KravitzLabDevices/Head_fixed_wheel/Parts_list/README.md

# Headfixed_5sipper
This is a repository containing parts and code for a 5-spout sipper device for head-fixed mouse experiments
