KravitzLabDevices/Head_fixed_wheel/Arduino_Code/Dependency_libraries/README

#GitHub Repositories for Arduino Libraries
## Download all .zip files and use Sketch >> 'add library' in Arduino IDE

## HG 12.4.2024
