KravitzLabDevices/Head_fixed_wheel/Parts_list/HeadfixedSipper_parts.xlsx

Sheet: All
REF | Part Name | Amount per wheel | Source (linked) | Part no. | Notes
To Purchase, Frame
F1 | 8" long, 1x1" 80/20 extruded aluminum rail | 8 per setup | 1010-Black | 1.00” X 1.00” T-Slotted Profile - Four Open T-Slots (https://8020.net/1010-black.html) | 1010-Black | Can be purchased through Workday from supplier "80-20 Inc"
F2 | Railing-to-headfix bracket 1 | 2 | THOR (https://www.thorlabs.com/thorproduct.cfm?partnumber=UPH1) | UPH1 (https://www.thorlabs.com/thorproduct.cfm?partnumber=UPH1)
F3 | Head-fix bars | 2 | OFMD | Ask Kevin! Send pictures :D
F4 | Optical table base | 1 x (300mm x 300mm minimum) + 1 x (125 x 125mm) (use P8 if necessary) | THOR (https://www.thorlabs.com/thorproduct.cfm?partnumber=MB3045/M) | MB3045/M (https://www.thorlabs.com/thorproduct.cfm?partnumber=MB3045/M)
F5 | Railing-to-headfix bracket 2 | 2 | THOR (https://www.thorlabs.com/thorproduct.cfm?partnumber=RA90TR) | RA90TR (https://www.thorlabs.com/thorproduct.cfm?partnumber=RA90TR)
F6 | Bracket, F1 to F4/P8 | 2 minimum, 4 recommended | Amazon, best I can find (https://www.amazon.com/Aluminum-Extrusion-Profile-Carbon-Bracket/dp/B0C7FQCY2J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) | or print it (P7)
F7 | Post, F2 to F5 | 2 | THOR (https://www.thorlabs.com/thorproduct.cfm?partnumber=TRA75/M) | TRA75/M (https://www.thorlabs.com/thorproduct.cfm?partnumber=TRA75/M)
F8 | 10 cm Threaded rod, elevates a P8 platform above base | 4 | THOR (https://www.thorlabs.com/thorproduct.cfm?partnumber=TRA100/M) | TRA100/M (https://www.thorlabs.com/thorproduct.cfm?partnumber=TRA75/M)
To Purchase, Wheel
R1 | Ball Bearings | 2 | Amazon (https://www.amazon.com/608-2RS-Skateboard-Bearing-Rolling-bearings/dp/B073ST742Z?hvadid=79920803460020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) | 608-2RS
R2 | Axle | 1 | Amazon (https://www.amazon.com/TOP-VIGOR-Threaded-Stainless-Threads-Studding/dp/B0D2624D6M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) | TOP VIGOR
R3 | Axle Coupling | 1 | Amazon (https://www.amazon.com/ZYCST-Aluminium-Coupling-Connector-Airplane/dp/B07QPJLQNH) | Treehobby, 6mm:6mm
R4 | Rotary encoder | 1 | Adafruit I2C Stemma QT (https://www.adafruit.com/product/5880) | Product ID: 5880
To Purchase, Liquid Dispensing
L1 | Modular, Linear Translation Stage | 3 modular parts for 3-axis manipulation, elevated by platform P8 (see frame) | Ebay, or PDV (https://www.ebay.com/itm/133963500697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) | 133963500697, or 2x "PP140-50" + 1x "PT-LWX90"
L2 | Solenoid valve | 1 minimum, up to 5 | The Lee Co (https://www.theleeco.com/product/hypodermic-port-outlet-vhs-series-solenoid-valve/) | INKA2426212H
L3 | Tubing | 2x ~3"-long tubing per solenoid valve-spout set (up to 10x) | Amazon (https://www.amazon.com/VictorsHome-Silicone-Flexible-Transfer-Transparent/dp/B09DKWWV7N) | VictorsHome
L4 | Metal Spouts (hand-bent) | 1 minimum, up to 5 | Amazon (https://www.amazon.com/uxcell-Stainless-Capillary-Industry-Machinery/dp/B0BX4BYH85) | uxcel
L5 | Liquid dispenser, 10mL Syringe | 1 minimum, up to 5 | Amazon (https://www.amazon.com/10ml-Syringe-Sterile-BH-SUPPLIES/dp/B07KW4KLG2) | BH Supplies
L6 | Rotary and extension servos | 2 | Amazon, best I can find (https://www.amazon.com/BETU-Servos-Helicopter-Airplane-Models/dp/B0BF8WZ7FK?xpid=A95qRS8cjkFae) | BETY
L7 | Solid-state relay (Dig. >> Ana.), sippers | 1 minimum, up to 5 | DigiKey (https://www.digikey.com/en/products/detail/littelfuse-inc/LCA715/1973278) | 5656-LCA715-ND
L8 | 2-pin Male JST cable | 1 minimum, up to 5 | Amazon (https://www.amazon.com/Upgraded-Connector-Battery-Inductrix-Eachine/dp/B07NWD5NTN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) | elechawk
L9 | Copper tape | Small amount, cut into ~2.5mm wide strip | Amazon, best I can find (https://www.amazon.com/Conductive-Adhesive-Soldering-Shielding-Grounding/dp/B09C24PNSW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) | Chanzon
L10 | One-channel relay, trigger for solenoids | 1 minimum, up to 5 | Amazon (https://www.amazon.com/HiLetgo-Channel-Optocoupler-Isolation-Trigger/dp/B0CHFJSNP6?xpid=0ctCJmBtzedeI) | HiLetGo
To print, wheel
P1 | Left wheel stand | 1 | GitHub/3D Designs | "Left_stand.stl"
P2 | Right wheel stand | 1 | GitHub/3D Designs | "Right_stand.stl"
P3 | Wheel | 1 | GitHub/3D Designs | "Wheel.stl"
OPTIONAL PRINT, INSTEAD OF ATTACHED LEFT ARM WITH ENCODER:
P1.1 | Left wheel stand | 1 | GitHub/3D Designs | "Magnificent Borwo.stl"
P1.2 | Rotary encoder stand (left) | 1 | GitHub/3D Designs | "Magnificent Borwo.stl"
To print, liquid dispensing
P4 | Spout setting | 1 | GitHub/3D Designs | Spout_holder.stl
P5 | Servo coupler/Extender arm | 1 | GitHub/3D Designs | Extender_arm.stl
P6 | Liquid Header | 1 | GitHub/3D Designs | Liquid_assembly.stl
OPTIONAL PRINTING FOR FRAME (F4 and F6 REPLACED BY P7 and P8)
P7 (r. F6) | Bracket, F1 to F4/P8 (printed) | 2 minimum, 4 recommended | GitHub/3D Designs | "Optical_board_bracket.stl"
P8 (r. F4) | Optical table base (printed, snap-together) | Each 125x125mm, 10 recommended (3x3 + 1) | GitHub/3D Designs | "Breadboard_125mm_interlocking.stl"
P8.1 | P8 snap-together L-brackets | 16 for 3x3 P8 assembly | GitHub/3D Designs | "Breadboard_125mm_long_peg.stl"
HARDWARE
H1 | 4040 Frame railing hardware | 4 x corner brackets, up to 12x T connectors + M8 bolts | Amazon.com: 24pcs Seekliny 4040 Aluminum Extrusion Corner Bracket 4040 Hardware V-Slot Accessories T-Slot with Screws for 8020 Aluminum Profile 3D Printer Accessories Black : Industrial & Scientific (https://www.amazon.com/Seekliny-Aluminum-Extrusion-Hardware-Accessories/dp/B0CWV1XTFY?th=1)
H2 | M6 hardware, assorte | 8x for frame to optical table, 4x for platform | Amazon.com: 172 Pcs M6 Screws Assortment Kit, M6x 8/10/12/16/20/25/30/35mm M6 Bolts Kit, 304 Stainless Steel Hex Socket Head Screws Nuts Bolts and Washers Set : Industrial & Scientific (https://www.amazon.com/Screws-Assortment-Stainless-Socket-Washers/dp/B0DFWMGFDM?s=hi)
H3 | M4 short binding barrel | 4x to attach 1 x P8 as platform to F7 | Amazon.com: Bettomshin 25Pcs M4 Binding Screw, M4 x 6mm Nickel Plated Carbon Steel Cross Head Butt Screw Binding Post Screw Kit for Scrapbook Photo Albums Bookbinding DIY Leather Saddles Purses Belt : Industrial & Scientific (https://www.amazon.com/Bettomshin-Binding-Scrapbook-Leather-Saddles/dp/B09SL155B8?s=hi)
H4 | 4040 Inside corner brackets (optional, if not using H1) | 4 x corner brackets + set screws | Amazon.com: 24pcs Seekliny 4040 Aluminum Extrusion Corner Bracket 4040 Hardware V-Slot Accessories T-Slot with Screws for 8020 Aluminum Profile 3D Printer Accessories Black : Industrial & Scientific (https://www.amazon.com/Seekliny-Aluminum-Extrusion-Hardware-Accessories/dp/B0CWV414WY?th=1)
H5 | Optical board pad/leveler | 4x | uxcell M6 x 25 x 30mm Hand Screw Leveling Feet Adjustable Leveler Floor Protector for Machine Furniture Table Desk Leg 4 Pack - Amazon.com (https://www.amazon.com/uxcell-Leveling-Adjustable-Protector-Furniture/dp/B07HG2B3W5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)
H6 | M2 socket cap bolts | 2x for headbar to mouse headfix cap | Amazon.com: Kozelo 10pcs Socket Head Cap Screws - [M2-0.4 x 8mm] Alloy Steel Black Oxide Grade 12.9 Internal Hex Screw for 3D Printer Furniture Industrial Use, Black : Industrial & Scientific (https://www.amazon.com/Kozelo-10pcs-Socket-Head-Screws/dp/B0DDKGT7H2?s=hi&sp_csd=d2lkZ2V0TmFtZT1zcF9hdGY)
H7 | Set Screws come with all THORLABS equipment, but are all M4. Can be found here: |  | https://www.amazon.com/Kadrick-Stainless-Screws-3mm-16mm-Lengths/dp/B0D962TJHX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
H8 | 1cm spacer | 2x [OPTIONAL, FOR SEPARATED ENCODER], holds rotary encoder stand at same level as axle | 10 Pack Round Rubber Spacers 1" OD x 3/8" ID x 1" Inch Thickness Black Thick Rubber Washers 1 Inch Round Rubber Spacer Rubber Bushings Flat Washers: Amazon.com: Industrial & Scientific (https://www.amazon.com/Rubber-Spacers-Thickness-Washers-Bushings/dp/B0CJ8XMS5C)
H9 | Sealant tape | Some length to cover axle and create tighter interface between axle and wheel | Dixon Valve TTB75 PTFE Industrial Sealant Tape, -212 to 500 Degree F Temperature Range, 3.5mil Thick, 520" Length, 3/4" Width, White: Thread Sealants: Amazon.com: Industrial & Scientific (https://www.amazon.com/Dixon-Valve-TTB75-Industrial-Temperature/dp/B003D7K8E0)
H10 | Nylon M2 hardware | 4x to secure rotary encoder to encoder stand | Lystaii 320pcs M2 Nylon Hex Spacer Standoff Kit Male Female Screw Nut Threaded Pillar Hex Standoff PCB Motherboard Circuit Board Standoffs Mounting Hardware Spacer Assortment Kit (Black, M2): Amazon.com: Industrial & Scientific (https://www.amazon.com/Lystaii-Standoff-Motherboard-Standoffs-Assortment/dp/B0BYSHZ2TD)
H11 | Miniature zipties | Up to 5, secure capacitive lick wiring to spout | Amazon.com: Nirah Industrial Grade Small Zip Ties 4 inches, Black, 1000 Pack, UV Resistant Multi-Purpose, Tiny Cable Ties, Mini Tie Wraps : Electronics (https://www.amazon.com/Nirah-Industrial-Resistant-Multi-Purpose-Premium/dp/B0BRWSZ57B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)
H12 | Servo Screws | Secure servos to rotary and linear extenders | HanTof 700Pcs Tiny Phillips Pan Head with Washer Self Tapping Screws, 304 Stainless Steel, Small/Mini M2 M2.3 M2.6 M3 Wood Screws, Micro Sheet Metal Screws Assortment Kit for Eletronic and Toy Repair: Amazon.com: Industrial & Scientific (https://www.amazon.com/HanTof-Phillips-Assortment-Eletronic-Stainless/dp/B0C4T1ZDYL)

Sheet: Frame Assembly
REF | Part Name | Amount per wheel | Source (linked) | Part no.
F1 | Frame railing/Extruded Rods | 3 minimum (one set of framework), 6 recommended | Alexnld (https://alexnld.com/product/machifit-400mm-length-4040-t-slot-aluminum-profiles-extrusion-frame-for-cnc/) | Product ID:5451518 (https://alexnld.com/product/machifit-400mm-length-4040-t-slot-aluminum-profiles-extrusion-frame-for-cnc/)
F2 | Railing-to-headfix bracket 1 | 2 | THOR (https://www.thorlabs.com/thorproduct.cfm?partnumber=UPH1) | UPH1 (https://www.thorlabs.com/thorproduct.cfm?partnumber=UPH1)
F3 | Head-fix bars | 2 | OFMD | Ask Kevin! Send pictures :D
F4 | Optical table base | 1 x (300mm x 300mm minimum) + 1 x (125 x 125mm) (use P8 if necessary) | THOR (https://www.thorlabs.com/thorproduct.cfm?partnumber=MB3045/M) | MB3045/M (https://www.thorlabs.com/thorproduct.cfm?partnumber=MB3045/M)
F5 | Railing-to-headfix bracket 2 | 2 | THOR (https://www.thorlabs.com/thorproduct.cfm?partnumber=RA90TR) | RA90TR (https://www.thorlabs.com/thorproduct.cfm?partnumber=RA90TR)
F6 | Bracket, F1 to F4/P8 | 2 minimum, 4 recommended | Amazon, best I can find (https://www.amazon.com/Aluminum-Extrusion-Profile-Carbon-Bracket/dp/B0C7FQCY2J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) | or print it (P7)
F7 | Post, F2 to F5 | 2 | THOR (https://www.thorlabs.com/thorproduct.cfm?partnumber=TRA75/M) | TRA75/M (https://www.thorlabs.com/thorproduct.cfm?partnumber=TRA75/M)
F8 | 10 cm Threaded rod, elevates a P8 platform above base | 4 | THOR (https://www.thorlabs.com/thorproduct.cfm?partnumber=TRA100/M) | TRA100/M (https://www.thorlabs.com/thorproduct.cfm?partnumber=TRA75/M)
OPTIONAL: PRINTING F4 and F6 INSTEAD OF PURCHASE
P7 (r. F6) | Bracket, F1 to F4/P8 (printed) | 2 minimum, 4 recommended | GitHub/3D Designs | "Optical_board_bracket.stl"
P8 (r. F4) | Optical table base (printed, snap-together) | Each 125x125mm, 10 recommended (3x3 + 1) | GitHub/3D Designs | "Breadboard_125mm_interlocking.stl"
P8.1 | P8 snap-together L-brackets | 16 for 3x3 P8 assembly | GitHub/3D Designs | "Breadboard_125mm_long_peg.stl"
HARDWARE
H1 | 4040 Frame railing hardware | 4 x corner brackets, up to 12x T connectors + M8 bolts | Amazon.com: 24pcs Seekliny 4040 Aluminum Extrusion Corner Bracket 4040 Hardware V-Slot Accessories T-Slot with Screws for 8020 Aluminum Profile 3D Printer Accessories Black : Industrial & Scientific (https://www.amazon.com/Seekliny-Aluminum-Extrusion-Hardware-Accessories/dp/B0CWV1XTFY?th=1)
H2 | M6 hardware, assorte | 8x for frame to optical table, 4x for platform | Amazon.com: 172 Pcs M6 Screws Assortment Kit, M6x 8/10/12/16/20/25/30/35mm M6 Bolts Kit, 304 Stainless Steel Hex Socket Head Screws Nuts Bolts and Washers Set : Industrial & Scientific (https://www.amazon.com/Screws-Assortment-Stainless-Socket-Washers/dp/B0DFWMGFDM?s=hi)
H3 | M4 short binding barrel | 4x to attach 1 x P8 as platform to F7 | Amazon.com: Bettomshin 25Pcs M4 Binding Screw, M4 x 6mm Nickel Plated Carbon Steel Cross Head Butt Screw Binding Post Screw Kit for Scrapbook Photo Albums Bookbinding DIY Leather Saddles Purses Belt : Industrial & Scientific (https://www.amazon.com/Bettomshin-Binding-Scrapbook-Leather-Saddles/dp/B09SL155B8?s=hi)
H4 | 4040 Inside corner brackets (optional, if not using H1) | 4 x corner brackets + set screws | Amazon.com: 24pcs Seekliny 4040 Aluminum Extrusion Corner Bracket 4040 Hardware V-Slot Accessories T-Slot with Screws for 8020 Aluminum Profile 3D Printer Accessories Black : Industrial & Scientific (https://www.amazon.com/Seekliny-Aluminum-Extrusion-Hardware-Accessories/dp/B0CWV414WY?th=1)
H5 | Optical board pad/leveler | 4x | uxcell M6 x 25 x 30mm Hand Screw Leveling Feet Adjustable Leveler Floor Protector for Machine Furniture Table Desk Leg 4 Pack - Amazon.com (https://www.amazon.com/uxcell-Leveling-Adjustable-Protector-Furniture/dp/B07HG2B3W5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)
H6 | M2 socket cap bolts | 2x for headbar to mouse headfix cap | Amazon.com: Kozelo 10pcs Socket Head Cap Screws - [M2-0.4 x 8mm] Alloy Steel Black Oxide Grade 12.9 Internal Hex Screw for 3D Printer Furniture Industrial Use, Black : Industrial & Scientific (https://www.amazon.com/Kozelo-10pcs-Socket-Head-Screws/dp/B0DDKGT7H2?s=hi&sp_csd=d2lkZ2V0TmFtZT1zcF9hdGY)
H7 | Set Screws come with all THORLABS equipment, but are all M4. Can be found here: |  | https://www.amazon.com/Kadrick-Stainless-Screws-3mm-16mm-Lengths/dp/B0D962TJHX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

Sheet: Wheel Assembly
REF | Part Name | Amount per wheel | Source | Part no.
R1 | Ball Bearings | 2 | Amazon (https://www.amazon.com/608-2RS-Skateboard-Bearing-Rolling-bearings/dp/B073ST742Z?hvadid=79920803460020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) | 608-2RS
R2 | Axle | 1 | Amazon (https://www.amazon.com/TOP-VIGOR-Threaded-Stainless-Threads-Studding/dp/B0D2624D6M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) | TOP VIGOR
R3 | Axle Coupling | 1 | Amazon (https://www.amazon.com/ZYCST-Aluminium-Coupling-Connector-Airplane/dp/B07QPJLQNH) | Treehobby, 6mm:6mm
R4 | Rotary encoder | 1 | Adafruit I2C Stemma QT (https://www.adafruit.com/product/5880) | Product ID: 5880
P1 | Left wheel stand | 1 | GitHub/3D Designs | "Left_stand.stl"
P2 | Right wheel stand | 1 | GitHub/3D Designs | "Right_stand.stl"
P3 | Wheel | 1 | GitHub/3D Designs | "Wheel.stl"
OPTIONAL PRINT, INSTEAD OF SINGLE LEFT ARM WITH ENCODER:
P1.1 | Left wheel stand | 1 | GitHub/3D Designs | "Magnificent Borwo.stl"
P1.2 | Rotary encoder stand (left) | 1 | GitHub/3D Designs | "Magnificent Borwo.stl"
HARDWARE
H2 | M6 hardware, assorted | Lock nuts, spacers, and nuts to secure rod, and 4x M6 nuts to secure stands to optical table | Amazon.com: 172 Pcs M6 Screws Assortment Kit, M6x 8/10/12/16/20/25/30/35mm M6 Bolts Kit, 304 Stainless Steel Hex Socket Head Screws Nuts Bolts and Washers Set : Industrial & Scientific (https://www.amazon.com/Screws-Assortment-Stainless-Socket-Washers/dp/B0DFWMGFDM?s=hi)
H7 | M4 Set screws | 2x for axle coupling | https://www.amazon.com/Kadrick-Stainless-Screws-3mm-16mm-Lengths/dp/B0D962TJHX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
H8 | 1cm spacer | 2x [OPTIONAL, FOR SEPARATED ENCODER], holds rotary encoder stand at same level as axle | 10 Pack Round Rubber Spacers 1" OD x 3/8" ID x 1" Inch Thickness Black Thick Rubber Washers 1 Inch Round Rubber Spacer Rubber Bushings Flat Washers: Amazon.com: Industrial & Scientific (https://www.amazon.com/Rubber-Spacers-Thickness-Washers-Bushings/dp/B0CJ8XMS5C)
H9 | Sealant tape | Some length to cover axle and create tighter interface between axle and wheel | Dixon Valve TTB75 PTFE Industrial Sealant Tape, -212 to 500 Degree F Temperature Range, 3.5mil Thick, 520" Length, 3/4" Width, White: Thread Sealants: Amazon.com: Industrial & Scientific (https://www.amazon.com/Dixon-Valve-TTB75-Industrial-Temperature/dp/B003D7K8E0)
H10 | Nylon M2 hardware | 4x to secure rotary encoder to encoder stand | Lystaii 320pcs M2 Nylon Hex Spacer Standoff Kit Male Female Screw Nut Threaded Pillar Hex Standoff PCB Motherboard Circuit Board Standoffs Mounting Hardware Spacer Assortment Kit (Black, M2): Amazon.com: Industrial & Scientific (https://www.amazon.com/Lystaii-Standoff-Motherboard-Standoffs-Assortment/dp/B0BYSHZ2TD)

Sheet: Liquid Assembly
REF | Part Name | Amount per wheel | Source | Part no.
L1 | Modular, Linear Translation Stage | 3 modular parts for 3-axis manipulation, elevated by platform P8 (see frame) | Ebay, or PDV (https://www.ebay.com/itm/133963500697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) | 133963500697, or 2x "PP140-50" + 1x "PT-LWX90"
L2 | Solenoid valve | 1 minimum, up to 5 | The Lee Co (https://www.theleeco.com/product/hypodermic-port-outlet-vhs-series-solenoid-valve/) | INKA2426212H
L3 | Tubing | 2x ~3"-long tubing per solenoid valve-spout set (up to 10x) | Amazon (https://www.amazon.com/VictorsHome-Silicone-Flexible-Transfer-Transparent/dp/B09DKWWV7N) | VictorsHome
L4 | Metal Spouts (hand-bent) | 1 minimum, up to 5 | Amazon (https://www.amazon.com/uxcell-Stainless-Capillary-Industry-Machinery/dp/B0BX4BYH85) | uxcel
L5 | Liquid dispenser, 10mL Syringe | 1 minimum, up to 5 | Amazon (https://www.amazon.com/10ml-Syringe-Sterile-BH-SUPPLIES/dp/B07KW4KLG2) | BH Supplies
L6 | Rotary and extension servos | 2 | Amazon, best I can find (https://www.amazon.com/BETU-Servos-Helicopter-Airplane-Models/dp/B0BF8WZ7FK?xpid=A95qRS8cjkFae) | BETY
L7 | Solid-state relay (Dig. >> Ana.), sippers | 1 minimum, up to 5 | DigiKey (https://www.digikey.com/en/products/detail/littelfuse-inc/LCA715/1973278) | 5656-LCA715-ND
L8 | 2-pin Male JST cable | 1 minimum, up to 5 | Amazon (https://www.amazon.com/Upgraded-Connector-Battery-Inductrix-Eachine/dp/B07NWD5NTN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) | elechawk
L9 | Copper tape | Small amount, cut into ~2.5mm wide strip | Amazon, best I can find (https://www.amazon.com/Conductive-Adhesive-Soldering-Shielding-Grounding/dp/B09C24PNSW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) | Chanzon
L10 | One-channel relay, trigger for solenoids | 1 minimum, up to 5 | Amazon (https://www.amazon.com/HiLetgo-Channel-Optocoupler-Isolation-Trigger/dp/B0CHFJSNP6?xpid=0ctCJmBtzedeI) | HiLetGo
P4 | Spout setting | 1 | GitHub/3D Designs | Spout_holder.stl
P5 | Servo coupler/Extender arm | 1 | GitHub/3D Designs | Extender_arm.stl
P6 | Liquid Header | 1 | GitHub/3D Designs | Liquid_assembly.stl
HARDWARE
H10 | Nylon M2 hardware | 4x to secure servos in slots | Lystaii 320pcs M2 Nylon Hex Spacer Standoff Kit Male Female Screw Nut Threaded Pillar Hex Standoff PCB Motherboard Circuit Board Standoffs Mounting Hardware Spacer Assortment Kit (Black, M2): Amazon.com: Industrial & Scientific (https://www.amazon.com/Lystaii-Standoff-Motherboard-Standoffs-Assortment/dp/B0BYSHZ2TD)
H11 | Miniature zipties | Up to 5, secure capacitive lick wiring to spout | Amazon.com: Nirah Industrial Grade Small Zip Ties 4 inches, Black, 1000 Pack, UV Resistant Multi-Purpose, Tiny Cable Ties, Mini Tie Wraps : Electronics (https://www.amazon.com/Nirah-Industrial-Resistant-Multi-Purpose-Premium/dp/B0BRWSZ57B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)
H12 | Servo Screws | Secure servos to rotary and linear extenders | HanTof 700Pcs Tiny Phillips Pan Head with Washer Self Tapping Screws, 304 Stainless Steel, Small/Mini M2 M2.3 M2.6 M3 Wood Screws, Micro Sheet Metal Screws Assortment Kit for Eletronic and Toy Repair: Amazon.com: Industrial & Scientific (https://www.amazon.com/HanTof-Phillips-Assortment-Eletronic-Stainless/dp/B0C4T1ZDYL)
