KravitzLabDevices/Head_fixed_wheel/PCB_Designs/JustinWheelPCB1.2.brd

## EAGLE design PCB_Designs/JustinWheelPCB1.2.brd (2025-12-03)

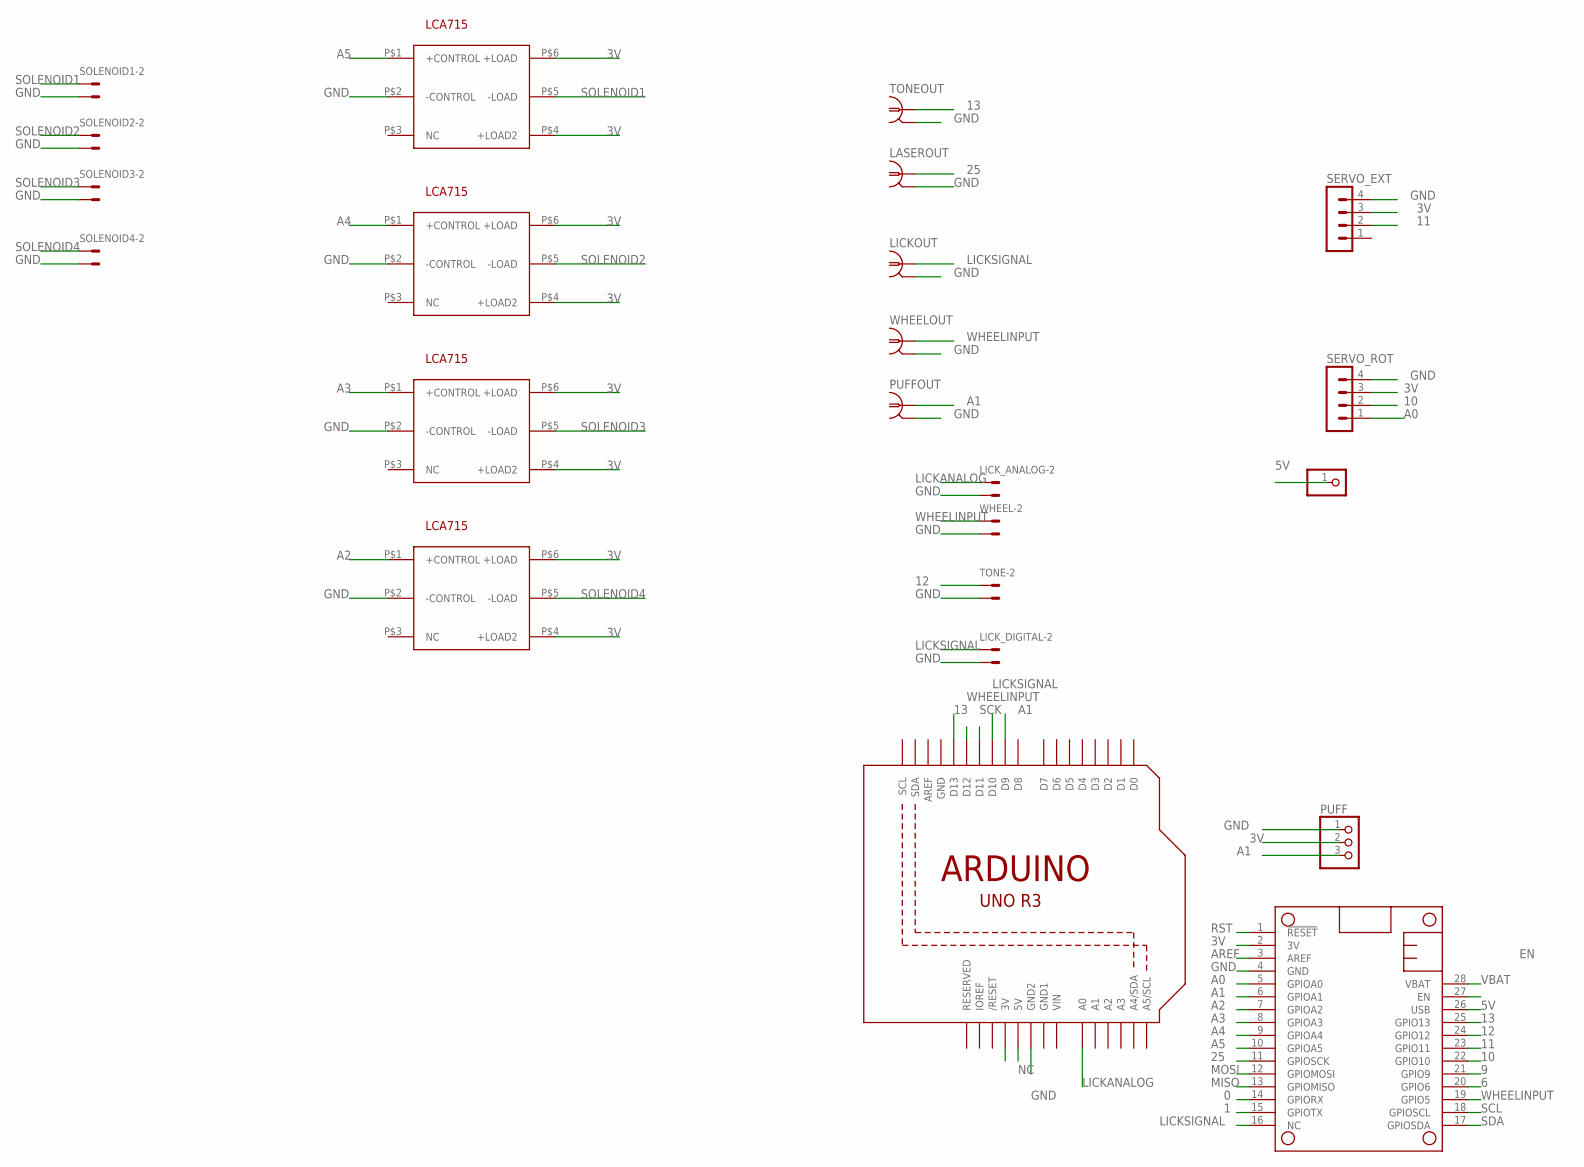
[picture p1: schematic JustinWheelPCB1.2.sch]

Parts:
JP1: PINHD-1X1; 1X01
LASEROUT: 1-227161-0; AMP_227161
LICKOUT: 1-227161-0; AMP_227161
LICK_ANALOG: 22-23-2021
LICK_DIGITAL: 22-23-2021
MS2: MICROSHIELD_NODIM; MICROSHIELD_DIM
PUFF: PINHD-1X3; 1X03
PUFFOUT: 1-227161-0; AMP_227161
SERVO_EXT: MA04-1
SERVO_ROT: MA04-1
SOL1, SOL2, SOL3, SOL4: LCA715S; LCA7XX
SOLENOID1, SOLENOID2, SOLENOID3, SOLENOID4: 22-23-2021
TONE: 22-23-2021
TONEOUT: 1-227161-0; AMP_227161
U1: ARDUINOR3-BPLACE
WHEEL: 22-23-2021
WHEELOUT: 1-227161-0; AMP_227161

Connections:
0: MS2.14 (GPIORX)
1: MS2.15 (GPIOTX)
3V: MS2.2 (3V), PUFF.2, SERVO_EXT.3, SERVO_ROT.3, SOL1.P$4 (+LOAD2), SOL1.P$6 (+LOAD), SOL2.P$4 (+LOAD2), SOL2.P$6 (+LOAD), SOL3.P$4 (+LOAD2), SOL3.P$6 (+LOAD), SOL4.P$4 (+LOAD2), SOL4.P$6 (+LOAD)
5V: JP1.1, MS2.26 (USB)
6: MS2.20 (GPIO6)
9: MS2.21 (GPIO9)
10: MS2.22 (GPIO10), SERVO_ROT.2
11: MS2.23 (GPIO11), SERVO_EXT.2
12: MS2.24 (GPIO12), TONE.1
13: MS2.25 (GPIO13), TONEOUT.1, U1.D13
25: LASEROUT.1, MS2.11 (GPIOSCK)
A0: MS2.5 (GPIOA0), SERVO_ROT.1
A1: MS2.6 (GPIOA1), PUFF.3, PUFFOUT.1, U1.D9
A2: MS2.7 (GPIOA2), SOL4.P$1 (+CONTROL)
A3: MS2.8 (GPIOA3), SOL3.P$1 (+CONTROL)
A4: MS2.9 (GPIOA4), SOL2.P$1 (+CONTROL)
A5: MS2.10 (GPIOA5), SOL1.P$1 (+CONTROL)
AREF: MS2.3 (AREF)
EN: MS2.27 (EN)
GND: LASEROUT.2, LICKOUT.2, LICK_ANALOG.2, LICK_DIGITAL.2, MS2.4 (GND), PUFF.1, PUFFOUT.2, SERVO_EXT.4, SERVO_ROT.4, SOL1.P$2 (-CONTROL), SOL2.P$2 (-CONTROL), SOL3.P$2 (-CONTROL), SOL4.P$2 (-CONTROL), SOLENOID1.2, SOLENOID2.2, SOLENOID3.2, SOLENOID4.2, TONE.2, TONEOUT.2, U1.GND, U1.GND2, WHEEL.2, WHEELOUT.2
GND1: U1.GND1
LICKANALOG: LICK_ANALOG.1, U1.A0
LICKSIGNAL: LICKOUT.1, LICK_DIGITAL.1, MS2.16 (NC), U1.D10
MISO: MS2.13 (GPIOMISO)
MOSI: MS2.12 (GPIOMOSI)
NC: U1.5V
RST: MS2.1 (!RESET)
SCK: U1.D11
SCL: MS2.18 (GPIOSCL)
SDA: MS2.17 (GPIOSDA)
SOLENOID1: SOL1.P$5 (-LOAD), SOLENOID1.1
SOLENOID2: SOL2.P$5 (-LOAD), SOLENOID2.1
SOLENOID3: SOL3.P$5 (-LOAD), SOLENOID3.1
SOLENOID4: SOL4.P$5 (-LOAD), SOLENOID4.1
VBAT: MS2.28 (VBAT)
VIN: U1.VIN
WHEELINPUT: MS2.19 (GPIO5), U1.D12, WHEEL.1, WHEELOUT.1

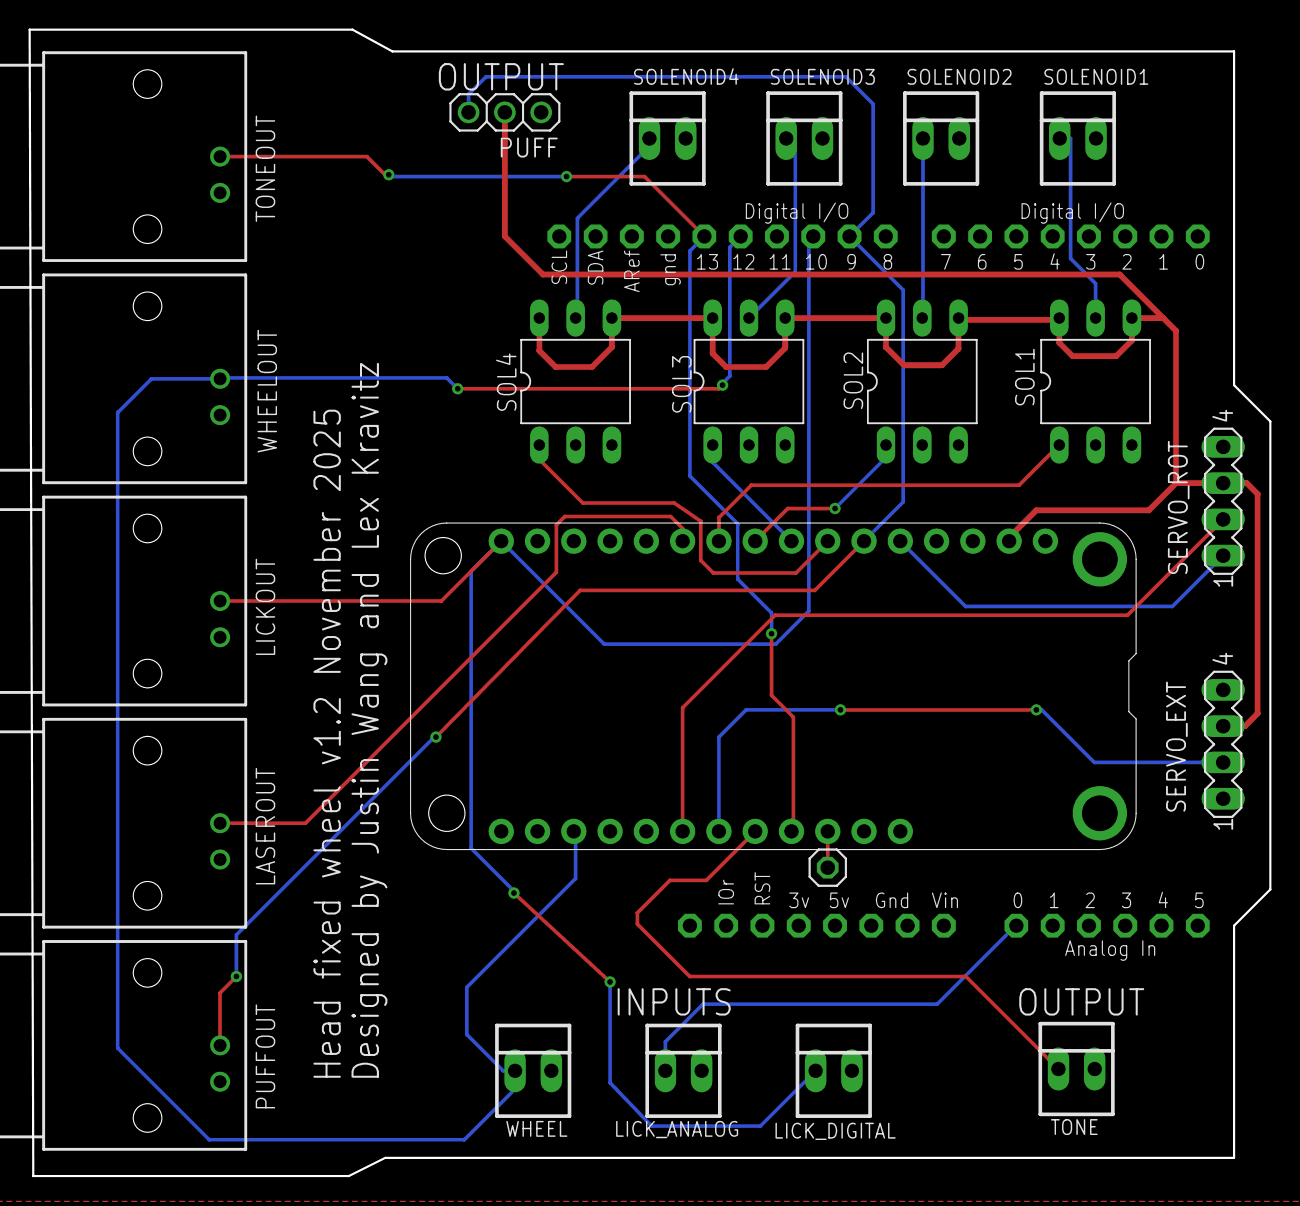
[picture p2: board JustinWheelPCB1.2.brd from above]

Board: 2 copper layers, 86.9 x 80.3 mm, 23 parts (0 on the bottom side), 21 nets.
