KravitzLabDevices/Head_fixed_wheel/Arduino_Code/KB2040_Wheel_Encoder/rotary_encoder_accessory.ino

/*
   This example shows how to read from a seesaw encoder module.
   The available encoder API is:
        int32_t getEncoderPosition();
        int32_t getEncoderDelta();
        void enableEncoderInterrupt();
        void disableEncoderInterrupt();
        void setEncoderPosition(int32_t pos);
*/
#include "Adafruit_seesaw.h"
#include <seesaw_neopixel.h>

#define SS_SWITCH        24
#define SS_NEOPIX        6

#define SEESAW_ADDR          0x36

Adafruit_seesaw ss;
seesaw_NeoPixel sspixel = seesaw_NeoPixel(1, SS_NEOPIX, NEO_GRB + NEO_KHZ800);

int32_t encoder_position;

void setup() {
  Serial.begin(115200);
  ss.begin(SEESAW_ADDR);
  sspixel.begin(SEESAW_ADDR);

  uint32_t version = ((ss.getVersion() >> 16) & 0xFFFF);

  // set not so bright!
  sspixel.setBrightness(20);
  sspixel.show();

  // use a pin for the built in encoder switch
  ss.pinMode(SS_SWITCH, INPUT_PULLUP);
  pinMode(A0, OUTPUT);


  // get starting position
  encoder_position = ss.getEncoderPosition();

  //enable ss package interrupts
  ss.setGPIOInterrupts((uint32_t)1 << SS_SWITCH, 1);
  ss.enableEncoderInterrupt();
}

void loop() {
  if (! ss.digitalRead(SS_SWITCH)) {
    Serial.println("Button pressed!");
  }

  int32_t new_position = ss.getEncoderPosition();
  // did we move around?
  if (encoder_position != new_position) {
    Serial.println(new_position);         // display new position

   
    digitalWrite(A0, HIGH);
    
    // change the neopixel color
    sspixel.setPixelColor(0, Wheel(new_position & 0xFF));
    sspixel.show();
    encoder_position = new_position;      // and save for next round
  }

  // don't overwhelm serial port
  delay(10);
  digitalWrite(A0, LOW);
}


uint32_t Wheel(byte WheelPos) {
  WheelPos = 255 - WheelPos;
  if (WheelPos < 85) {
    return sspixel.Color(255 - WheelPos * 3, 0, WheelPos * 3);
  }
  if (WheelPos < 170) {
    WheelPos -= 85;
    return sspixel.Color(0, WheelPos * 3, 255 - WheelPos * 3);
  }
  WheelPos -= 170;
  return sspixel.Color(WheelPos * 3, 255 - WheelPos * 3, 0);
}
