KravitzLabDevices/Head_fixed_wheel/Arduino_Code/M4_Control_Code/positionAlignment.ino

void positionAlignment() {

  retract();
  spoutPosition(3);
  extend(3);
  delay(3000);

  retract();
  spoutPosition(1);
  extend(1);
  delay(3000);

  retract();
  spoutPosition(2);
  extend(2);
  delay(3000);

  retract();
  spoutPosition(4);
  extend(4);
  delay(3000);

  retract();
  spoutPosition(5);
  extend(5);
  delay(3000);
  
}
