KravitzLabDevices/Head_fixed_wheel/Arduino_Code/M4_Control_Code/positionShuffle.ino

int positionShuffle() {
  int randomIndex;

  do {
    randomIndex = random(NUM_COUNT);
  } while (randomIndex == lastPickedIndex);

  int pickedNumber = numbers[randomIndex];
  lastPickedIndex = randomIndex;

  return pickedNumber;
}
