KravitzLabDevices/Head_fixed_wheel/(commit log)

2025-12-03 Add JustinWheelPCB v1.2 board and schematic files
    Initial commit of the JustinWheelPCB version 1.2 Eagle board (.brd) and schematic (.sch) files. These files define the PCB layout and circuit design for the head fixed wheel project.
    [JustinWheelPCB1.2.brd, JustinWheelPCB1.2.sch]
2025-12-03 Restructure project directories and remove unused files
    Moved Arduino libraries, Bonsai code, and PCB designs to new organized directories. Renamed main lickometer code file. Deleted multiple unused Arduino code modules, header files, and setup documentation to clean up the repository.
    [JustinWheelPCB1.2.brd, JustinWheelPCB1.2.sch]
2025-12-03 Add README files for KB2040 and M4 control code
    Added initial README.md files to the KB2040_Wheel_Encoder and M4_Control_Code directories, providing a brief description of the 5-spout sipper device for head-fixed mouse experiments.
